drzzzf/T12SoldingStation/Readme.md

我是羊羹爸爸。
本烙铁的原始设计完全来自以下这位大神的开源项目。
其中有完整的解说文档，如果你看了我的视频也想制作这个烙铁，可以先访以下地址
https://github.com/wagiminator/ATmega-Soldering-Station

我的代码是基于原版代码1.7版本修改的，所以使用的类库和编译环境请参考原始网站的说明。
pcb是基于原版2.7修改的，只是加入了一个传感器，对原始电路并没有改动，所以应该可以兼容原始项目的程序。
我的这把烙铁的diy视频，等发布以后，会把链接更新到这里。
