drzzzf/T12SoldingStation/BOM_SolderingStation_2021-04-13.csv

ID | Name | Designator | Footprint | Quantity | Manufacturer Part | Manufacturer | Supplier | Supplier Part | Price | JLCPCB SMD | LCSC Assembly | Assembly Type | Paste Type
1 | 10K | 10K | R0603 | 1 | 0603WAF1002T5E | UniOhm | LCSC | C25804 | 0.001 | Yes | Yes | smtWeld | base
2 | 16MHz | 16MHZ | OSC-SMD_4P-L3.2-W2.5-BL | 1 | X322516MLB4SI | YXC | LCSC | C13738 | 0.093 | Yes | Yes | smtWeld | base
3 | MLT-5030 | BUZZER1 | MLT-5030 | 1 | MLT-5030 | HNDZ | LCSC | C95297 | 0.5879
4 | 100n | C1,C2,C3,C9,C10 | 0603 | 5 | CC0603KRX7R9BB104 | YAGEO | LCSC | C14663 | 0.0034
5 | 47u | C4 | 1206 | 1 | 1206F476M100NT | FH | LCSC | C30349 | 0.076
6 | 22p | C5,C6 | 0603 | 2 | CL10C220JB8NNNC | SAMSUNG | LCSC | C1653 | 0.0055
7 | 10u | C7 | 1206 | 1 | GMK316BJ106KL-T | Taiyo Yuden | LCSC | C92797 | 0.0878
8 | 2n2 | C8 | 0603 | 1 | 0603B222K500NT | FH | LCSC | C1604 | 0.005
9 | 330n | C11 | 0603 | 1 | C1608X7R1H334KT000E | TDK | LCSC | C76621 | 0.0548
10 | 22u | C12 | 1206 | 1 | C3216X5R1V226MTJ00E | TDK | LCSC | C342620 | 0.5107
11 | 1u | C13 | 0603 | 1 | CL10A105KB8NNNC | SAMSUNG | LCSC | C15849 | 0.0085
12 | TCRT5000L | CGQ1 | OPTO-TH_TCRT5000L | 1 | TCRT5000L | VISHAY | LCSC | C24085 | 0.6497 |  | Yes | manualWeld | expand
13 | SS54 | D1 | DIODE-SMA(DO-214AC) | 1 | SS54 | Jingdao | LCSC | C123946 | 0.0457 |  | Yes
14 | 1N4148W | D2 | DIODE-SOD-123 | 1 | 1N4148W-E3-08 | Vishay Intertech | LCSC | C241939 | 0.0401
15 | 5V1 | D3 | ZENER-SOD-123 | 1 | MM1Z5V1 | SEMTECH | LCSC | C81601 | 0.0194 |  | Yes
16 | 18V | D4 | ZENER-SOD-123 | 1 | MM1Z18 | Jingdao | LCSC | C116111 | 0.0154 |  | Yes
17 | ICSP-6 | ICSP | ICSP-6 | 1 | ?
18 | PWR | LED1 | LED0603 | 1 | 19-217/BHC-ZL1M2RY/3T | EVERLIGHT | LCSC | C72041 | 0.0152
19 | OLED | OLED | I2C - OLED 0.96" 128X64 | 1 | SSD1306 I2C OLED
20 | KF350-3.5mm | P1,P2,P3 | KF350-2P | 3 | WJ2EDGVC-5.08-2P | ReliaPro | LCSC | C8445 | 0.0445
21 | FMMT619 | Q1 | SOT-23-3_L2.9-W1.6-P1.90-LS2.8-BR | 1 | FMMT619 | CJ | LCSC | C53071 | 0.0454 |  | Yes
22 | IRLR7843TRPBF | Q2 | TO-252-2 | 1 | IRLR7843TRPBF | IR | LCSC | C21988 | 0.7408 |  | Yes
23 | 1k5 | R2 | 0603 | 1 | 0603WAF1501T5E | UniOhm | LCSC | C22843 | 0.0012
24 | 1k | R5 | 1206 | 1 | 1206W4F1001T5E | UniOhm | LCSC | C4410 | 0.0042
25 | 10k | R1,R3,R4,R6,R7,R10,R11,R13,R14 | 0603 | 9 | 0603WAF1002T5E | UniOhm | LCSC | C25804 | 0.001
26 | 200k | R8 | 0603 | 1 | 0603WAF2003T5E | UniOhm | LCSC | C25811 | 0.0012
27 | 1k | R9 | 0603 | 1 | 0603WAF1001T5E | UniOhm | LCSC | C21190 | 0.001
28 | 47k | R12 | 0603 | 1 | 0603WAF4702T5E | UniOhm | LCSC | C25819 | 0.0012
29 | 510 | R16 | R0603 | 1 | 0603WAF5100T5E | UniOhm | LCSC | C23193 | 0.0012 | Yes | Yes | smtWeld | base
30 | 3x6x2.5 | RESET | KEY-3.0*6.0 | 1 | 3x6x2.5Red head high temperature | ReliaPro | LCSC | C46491 | 0.0227
31 | Rotary Enc | SW1 | BOURNS_PEC11R-4XXXF-SXXXX | 1 | PEC11R-4015F-S0024 | BOURNS | LCSC | C143789 | 1.5491
32 | ATMEGA328P-AU | U1 | TQFP-32_7X7X08P | 1 | ATMEGA328P-AU | MICROCHIP | LCSC | C14877 | 1.8622 |  | Yes
33 | 78M05 | U2 | TO-252-2 | 1 | ME78M05K3G | MICRONE | LCSC | C83969 | 0.0898 |  | Yes
34 | LMV358IDR | U3 | SOP-8_150MIL | 1 | LMV358IDR | TI | LCSC | C63813 | 0.1657 |  | Yes
