drzzzf/T12SoldingStation/SolderingStationCase.stl

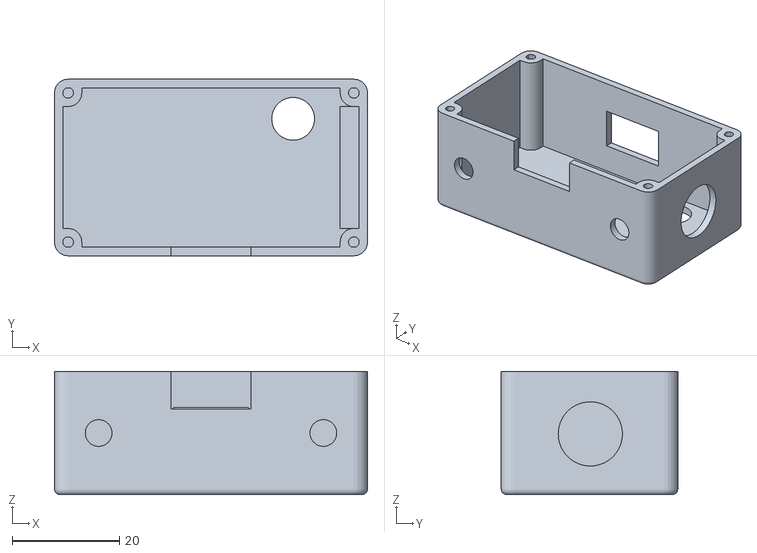
[picture p1: CAD file, 2021-04-16]
SolderingStationCase.stl
58.5 x 33.0 x 23.0
