drzzzf/T12SoldingStation/SolderStaionShortNob.stl

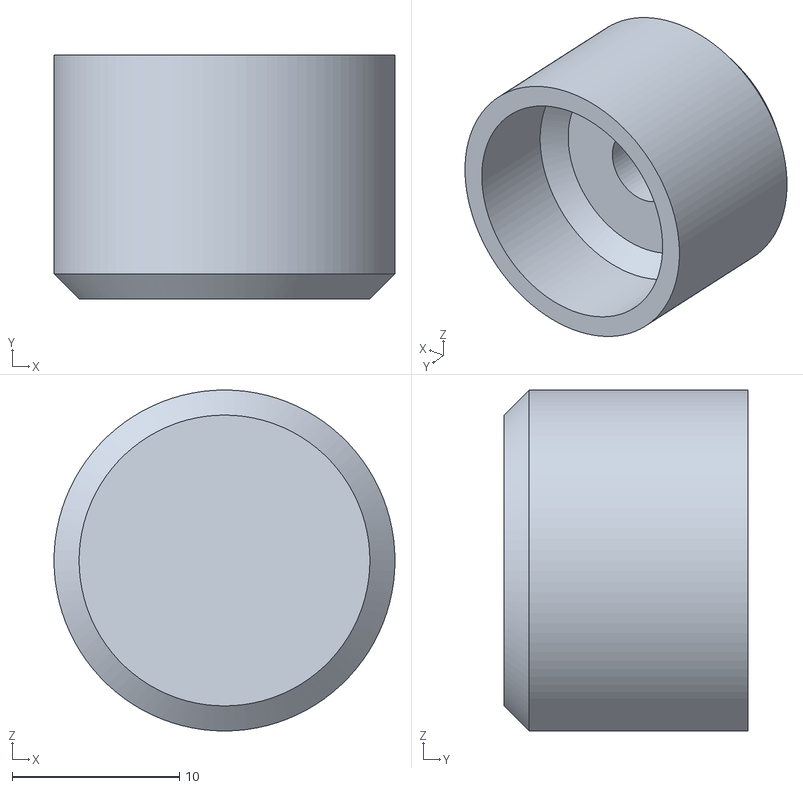
[picture p2: CAD file, 2021-04-16]
SolderStaionShortNob.stl
20.4 x 14.6 x 20.4
