drzzzf/T12SoldingStation/Schematic_t12dev_2021-04-16.pdf

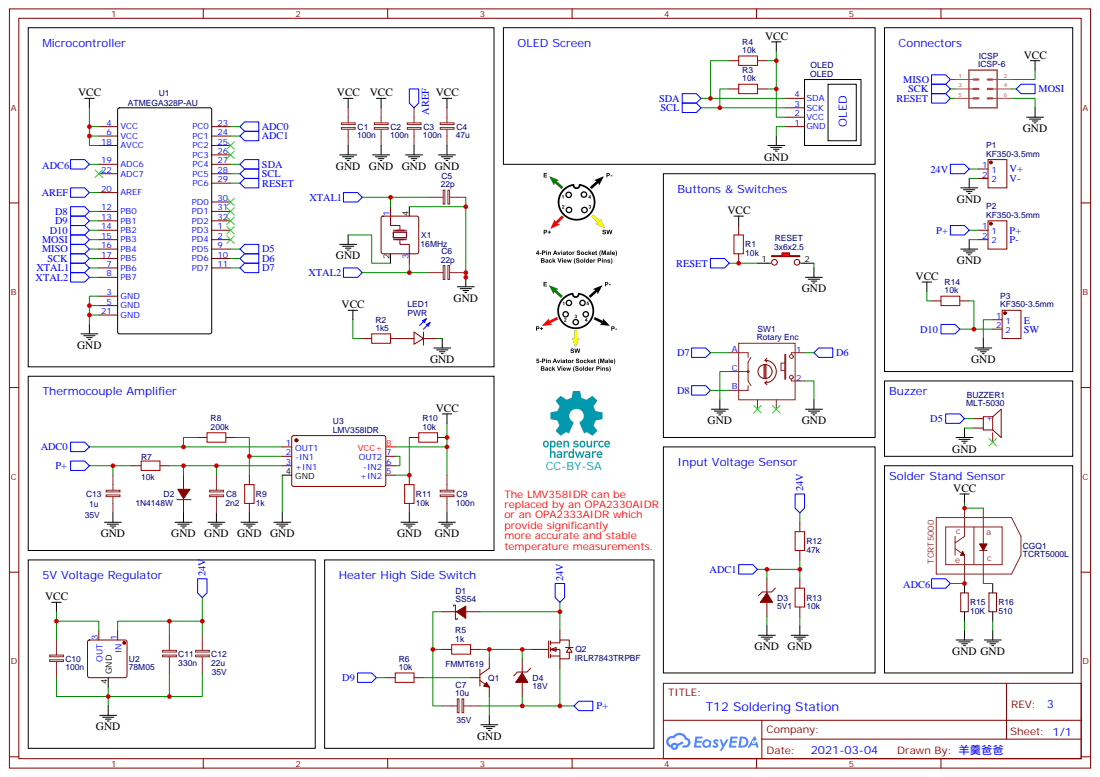
[picture p3: page 1]

GND GND

The LMV358IDR can be
replaced by an OPA2330AIDR
or an OPA2333AIDR which
provide significantly
more accurate and stable
temperature measurements.

Heater High Side Switch
