drzzzf/T12SoldingStation/(commit log)

2021-07-31 不偷懒，修改写死的距离可调节
2023-04-24 贡献代码中遗漏部分的补充
